cruwaller/FENIX-rx5808-pro-diversity/README.md

https://discord.gg/gG2sjjK

Diversity receiver designed around an ESP32 and touchpad UI.

  *   15 kHz antenna switching rate e.g. once every NTSC video line.
  *   72 selectable frequencies
  *   Rapid spectrum analyser with selectable peaks.  See below for more details.
  *   Switch from diversity mode, to single antenna mode (A or B).

Menu demo (36 seconds) https://www.youtube.com/watch?v=VTEIN2PMyIs

Indoor flight (29 seconds) https://www.youtube.com/watch?v=gvrL2I_6KYo

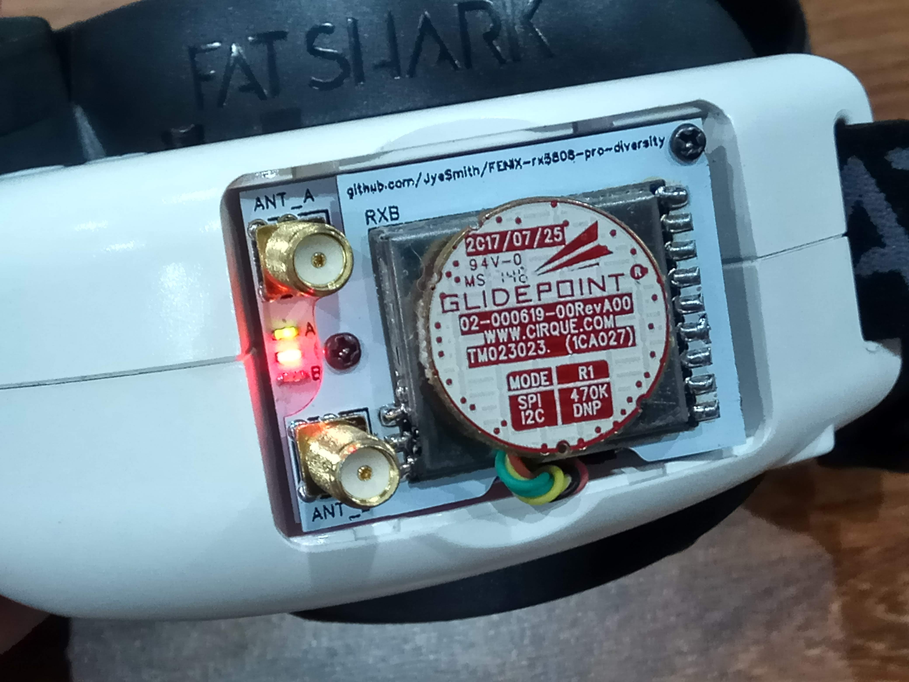
[picture p1: docs/img/InGoggles.jpg]


**Calibration**

When first built and turned on you will be greeted with a calibration screen.  Set a VTx to 25 mW and on your favourite band/frequency (F4 for 5800 MHz) and place the VTx next to the goggles.  Tap the touchpad and the module will sweep all frequencies tracking maximum and minimum RSSI values.  When completed you will see the final min/max values for each receiver and can tapping again saves these values.

The calibration process can be repeated by tapping the ‘on time’ in the upper right corner.  This will change when a proper settings menu has be completed.

**Band selection**

Cycle through bands A, B, E, F, R, L, U, O, H by tapping on the upper or lower half of the band letter.

**Channel selection**

Cycle through channels 1-8 by tapping on the upper or lower half of the channel number.

**Diversity or single antenna selection**

Tapping on mode cycles through diversity, antenna A, and antenna B modes.

**Spectrum analyser**

Moving the cursor to the lower half of the screen starts the spectrum analyser.

_**Note** the screen will timeout after 2 seconds when the cursor is in the top half of the screen, but will not timeout when in the lower half and spectrum analyser is running._

The spectrum displays the RSSI detected for each of the 72 channels/bands.  A peak can be tapped on to select this frequency.  When selecting a peak the module will sweep across the peak in 1 MHz steps and determine the center frequency of the peak.  The receivers are then set to the band/channel closest to this center frequency.

## BOM

  *   1 x PCB - Upload the Gerber.zip found in the PCB folder to jlcpcb.com, select 1mm thickness and your favourite colour. https://easyeda.com/jyesmith/esp32-fatshark-module-v3
  *   1 x GlidePoint circle pads Part Number (SPI) TM023023-2024-002
     *   https://www.cirque.com/glidepoint-circle-trackpads
     *   https://au.mouser.com/ProductDetail/Cirque/TM023023-2024-002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
  *   1 x TTGO Micro-32
     *   https://www.aliexpress.com/item/Ttgo-Micro-32-V2-0-Wifi-Wireless-Bluetooth-Module-Esp32-Pico-D4-Ipex-Esp-32/32982085061.html
  *   2 x RX5808.  The receiver linked below has given better results than the more commonly available receiver (the version without the 2 extra tabs).  The RSSI voltage range is  larger and the minimum RSSI is consistent across all frequencies.
     *   https://www.aliexpress.com/item/Swiftflying-Boscam-FPV-5-8G-Wireless-Audio-Video-Receiving-Module-For-RX5808/32841092602.html
  *   2 x Antenna Connectors
     *   https://www.aliexpress.com/item/5-pcs-RF-Coaxial-Long-SMA-Female-Straight-Edge-15mm-tooth-PCB-Connector-Adapter/32913905715.html
  *   1 x SPDT Analog Switch TS5A3159ADBVR SOT-23
     *   http://www.ti.com/lit/ds/symlink/ts5a3159a.pdf
  *   3.3V Regulator AMS1117-3.3
  *   2 x 10uF 0603 SMD Capacitors
  *   1 x 0.1uF 0603 SMD Capacitor
  *   1 x 10k 0603 SMD Resistors (EN pullup)
  *   2 x 100k 0603 SMD Resistors (RSSI pulldown)
  *   3 x 510 ohm 0603 SMD Resistors (LEDs) (Optional)
  *   3 x 0603 LEDs.  1 (red) for power and 2 (green) for indicating which antenna is selected (Optional)
  *   1 x boot button
  *   1 x 9 pin header
  *   2 x 4mm M2 standoffs and screws

# Wiring

https://easyeda.com/jyesmith/esp32-fatshark-module-v3

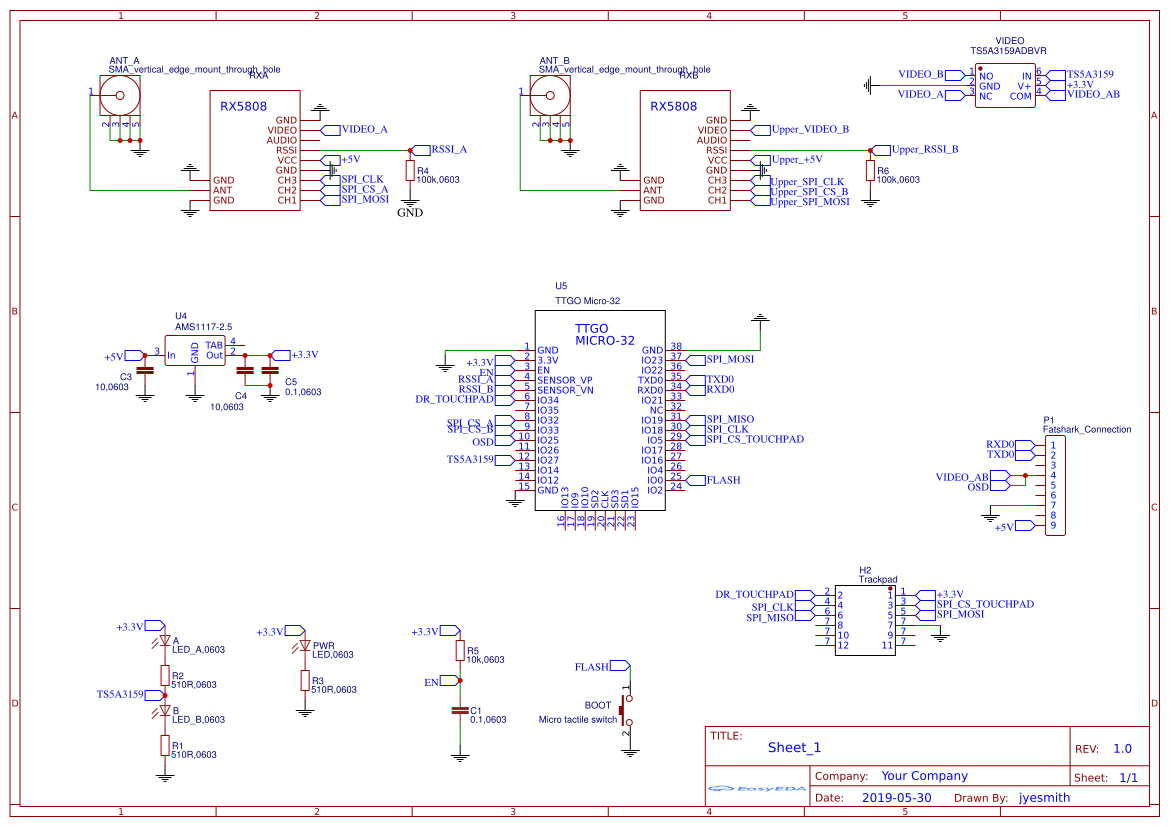
[picture p2: PCB/Schematic.png]
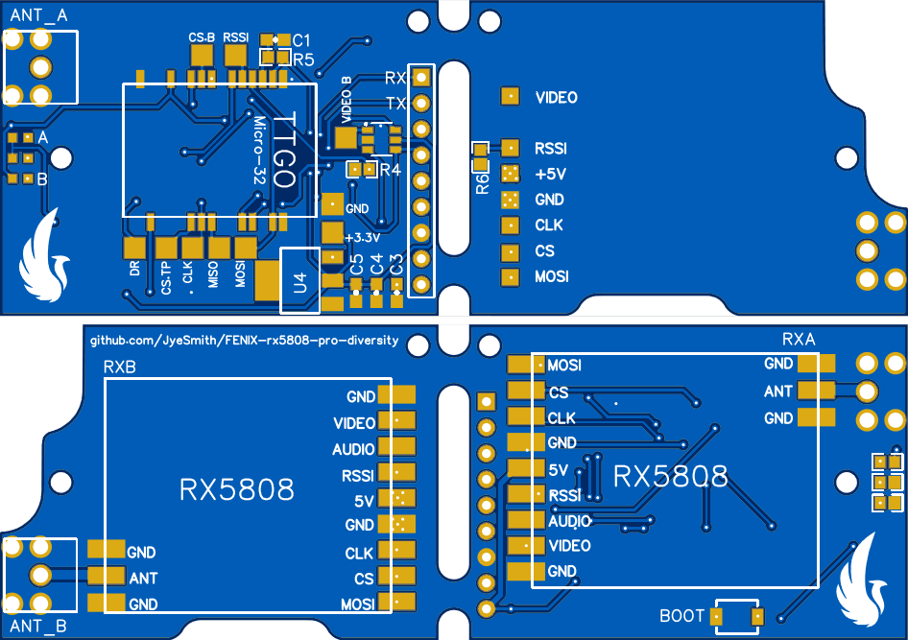
[picture p3: PCB/PCB.png]
 

The touchpad works better with a cover.  I use a piece of electric tape.

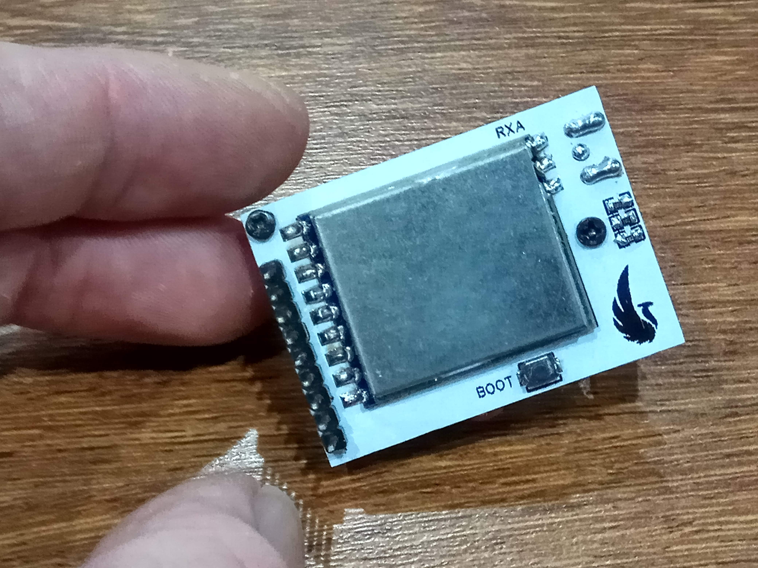
[picture p4: docs/img/BackFinished.jpg]
 

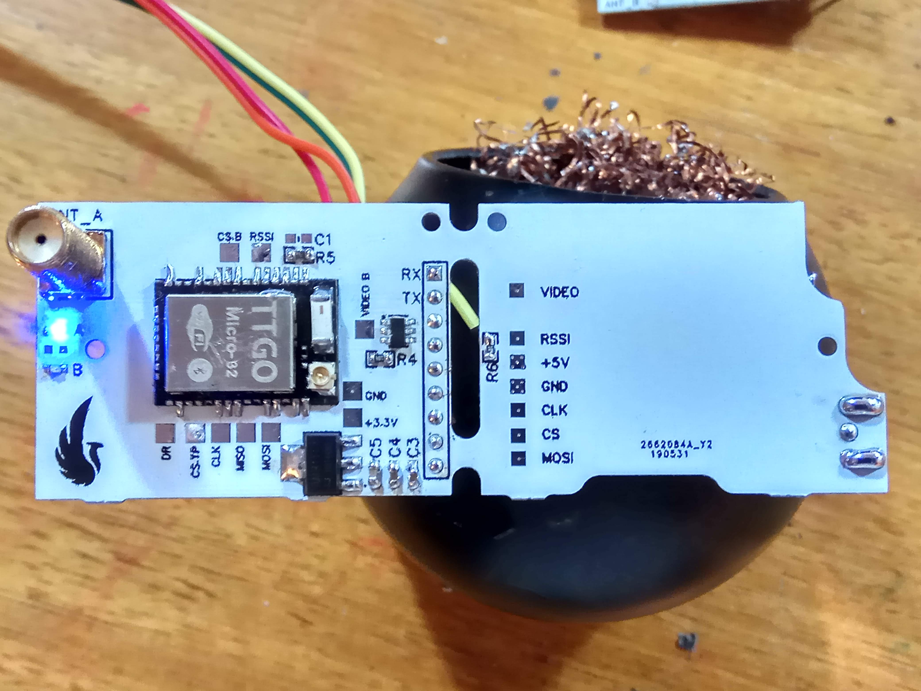
[picture p5: docs/img/Front1Build.jpg]
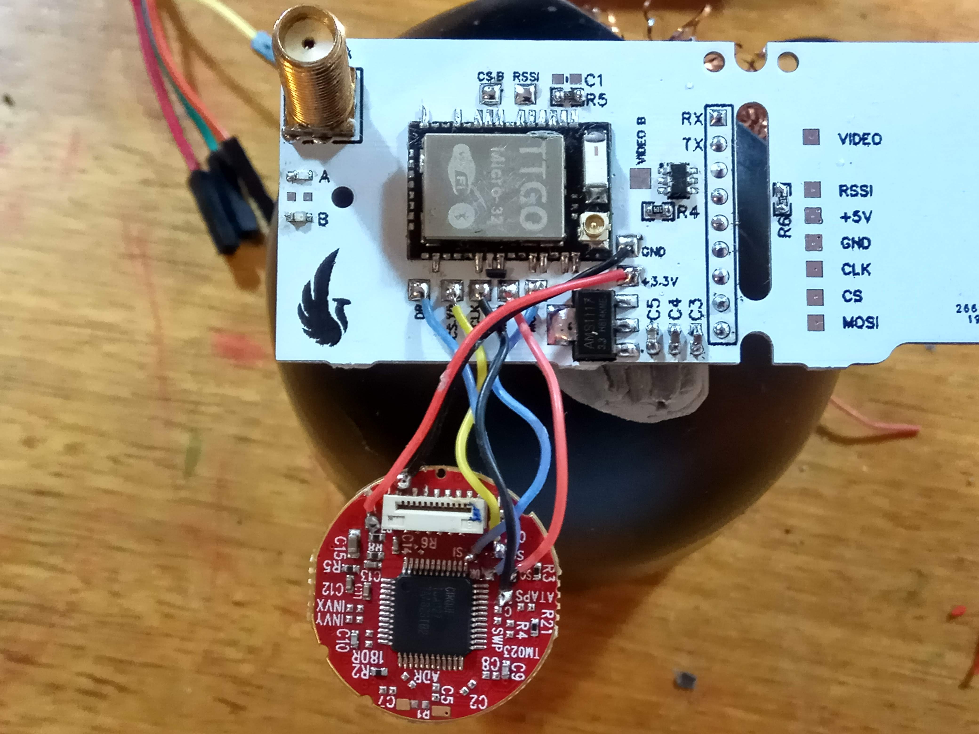
[picture p6: docs/img/Front2Build.jpg]
 

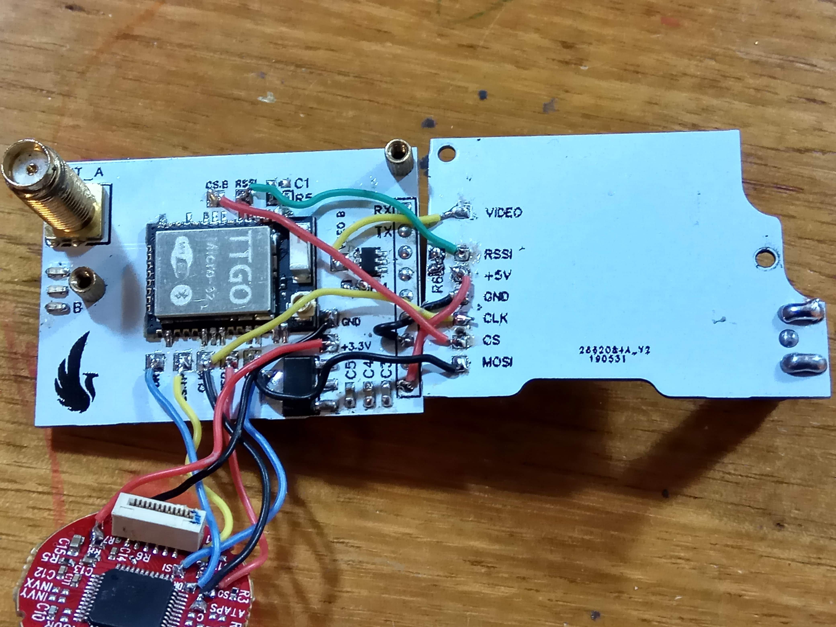
[picture p7: docs/img/Front3Build.jpg]
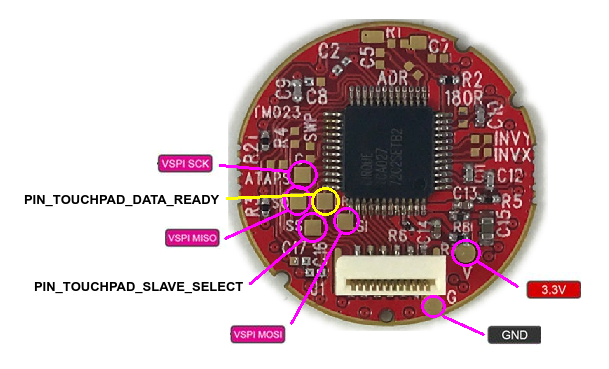
[picture p8: docs/img/TouchPadWiring.png]
 

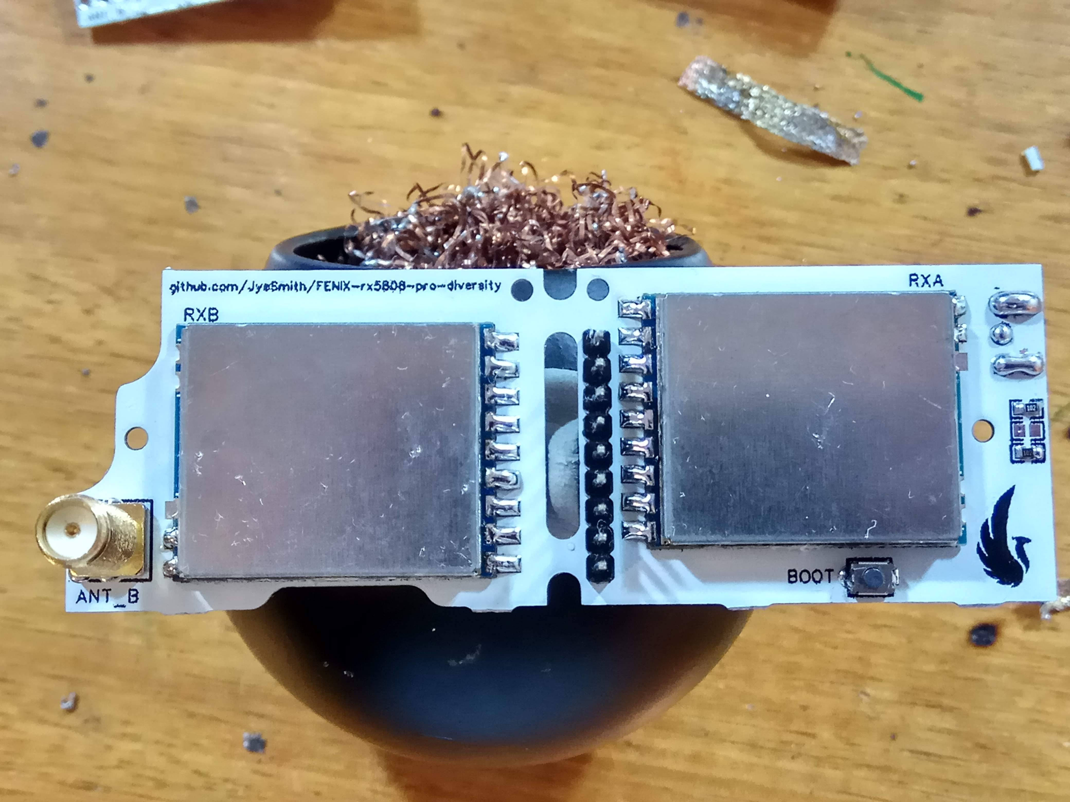
[picture p9: docs/img/BackBuild.jpg]


## Flashing

Tx and Rx pins to the TTGO are broken out to the upper 2 pins that plug into the goggles.  Connect these, along with GND (pin 3rd from bottom) and 5V (bottom pin), then flash using your favourite FTDI.

## Recognition

This code is a forked from [sheaivey/rx5808-pro-diversity](https://github.com/sheaivey/rx5808-pro-diversity).

## Code

The code is distributed under the [MIT license](LICENSE.md).
