cruwaller/FENIX-rx5808-pro-diversity/src/src/rx5808-pro-diversity.cpp

/*
   SPI driver based on fs_skyrf_58g-main.c Written by Simon Chambers
   TVOUT by Myles Metzel
   Scanner by Johan Hermen
   Inital 2 Button version by Peter (pete1990)
   Refactored and GUI reworked by Marko Hoepken
   Universal version my Marko Hoepken
   Diversity Receiver Mode and GUI improvements by Shea Ivey
   OLED Version by Shea Ivey
   Seperating display concerns by Shea Ivey

  The MIT License (MIT)

  Copyright (c) 2015 Marko Hoepken

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
  THE SOFTWARE IS PROVIDED "AS IS", WITHOUT WARRANTY OF ANY KIND, EXPRESS OR
  IMPLIED, INCLUDING BUT NOT LIMITED TO THE WARRANTIES OF MERCHANTABILITY,
  FITNESS FOR A PARTICULAR PURPOSE AND NONINFRINGEMENT. IN NO EVENT SHALL THE
  AUTHORS OR COPYRIGHT HOLDERS BE LIABLE FOR ANY CLAIM, DAMAGES OR OTHER
  LIABILITY, WHETHER IN AN ACTION OF CONTRACT, TORT OR OTHERWISE, ARISING FROM,
  OUT OF OR IN CONNECTION WITH THE SOFTWARE OR THE USE OR OTHER DEALINGS IN THE
  SOFTWARE.
*/


#include "settings.h"
#include "settings_eeprom.h"
#include "state_home.h"
#include "channels.h"
#include "receiver.h"
#include "receiver_spi.h"
#include "state.h"
#include "ui.h"
#include "voltage.h"
#include "temperature.h"
#include "touchpad.h"
#include "receiver_spi.h"
#include "comm_espnow.h"

#include <SPI.h>

void setupPins();

#ifdef SPEED_TEST
uint32_t speed_test_hz = 0;
uint32_t speed_test_previousTime = 0;
#endif

void setup()
{
#if DEBUG_ENABLED || defined(SPEED_TEST)
    Serial.begin(115200);
#endif

    EepromSettings.setup();
    setupPins();

    SPI.begin();
    SPI.setHwCs(false);

    StateMachine::setup();
    Ui::setup();
    TouchPad::setup();

    /* Setup receivers and cofigure its registers */
    ReceiverSpi::setup();

    // Has to be last setup() otherwise channel may not be set.
    // RX possibly not booting quick enough if setup() is called earler.
    // delay() may be needed.
    Receiver::setup();

    if (!EepromSettings.isCalibrated) {
        StateMachine::switchState(StateMachine::State::SETTINGS_RSSI);
        Ui::tvOn();
    } else {
        StateMachine::switchState(StateMachine::State::HOME);
    }

    comm_espnow_init();
}

void setupPins() {

#if !DEBUG_ENABLED && !defined(SPEED_TEST)
    // Rx and Tx set as input so that they are high impedance when conencted to goggles.
    pinMode(1, INPUT);
    pinMode(3, INPUT);
#endif

    // Init CS pins here to make sure those are in correct state before configuration is performed
    pinMode(PIN_TOUCHPAD_SLAVE_SELECT, OUTPUT);
    digitalWrite(PIN_TOUCHPAD_SLAVE_SELECT, HIGH);

    pinMode(PIN_SPI_SLAVE_SELECT_RX_A, OUTPUT);
    digitalWrite(PIN_SPI_SLAVE_SELECT_RX_A, HIGH);

    pinMode(PIN_SPI_SLAVE_SELECT_RX_B, OUTPUT);
    digitalWrite(PIN_SPI_SLAVE_SELECT_RX_B, HIGH);

    pinMode(PIN_RX_SWITCH, OUTPUT);
    digitalWrite(PIN_RX_SWITCH, LOW);

    pinMode(PIN_RSSI_A, INPUT);
    pinMode(PIN_RSSI_B, INPUT);
#ifdef PIN_VBAT
    analogSetPinAttenuation(PIN_VBAT, ADC_2_5db);
#endif
}

void loop() {
    Receiver::update();
    TouchPad::update();

    if (Ui::isTvOn) {

#ifdef USE_VOLTAGE_MONITORING
        Voltage::update();
#endif
        Ui::display.begin(0); // reset OSD to black
        StateMachine::update();
        Ui::update();
        Ui::display.end(); // draw OSD

        if (Ui::UiTimeOut.hasTicked() &&
            StateMachine::currentState != StateMachine::State::SETTINGS_RSSI )
        {
            Ui::tvOff();
            EepromSettings.update();
        }
    }
    else if (TouchPad::touchData.buttonPrimary) // TV is off, check if touch has happened
    {
        Ui::tvOn();
    }

    TouchPad::clearTouchData();

#ifdef SPEED_TEST
        speed_test_hz++;
        uint32_t nowTime = millis();
        if (1000u <= (nowTime - speed_test_previousTime)) {
            Serial.print(speed_test_hz);
            Serial.println(" Hz");
            speed_test_previousTime = nowTime;
            speed_test_hz = 0;
        }
#endif // SPEED_TEST
}
