cruwaller/FENIX-rx5808-pro-diversity/src/src/settings.h

/*
 * Setings file by Shea Ivey

The MIT License (MIT)

Copyright (c) 2015 Shea Ivey

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
THE SOFTWARE IS PROVIDED "AS IS", WITHOUT WARRANTY OF ANY KIND, EXPRESS OR
IMPLIED, INCLUDING BUT NOT LIMITED TO THE WARRANTIES OF MERCHANTABILITY,
FITNESS FOR A PARTICULAR PURPOSE AND NONINFRINGEMENT. IN NO EVENT SHALL THE
AUTHORS OR COPYRIGHT HOLDERS BE LIABLE FOR ANY CLAIM, DAMAGES OR OTHER
LIABILITY, WHETHER IN AN ACTION OF CONTRACT, TORT OR OTHERWISE, ARISING FROM,
OUT OF OR IN CONNECTION WITH THE SOFTWARE OR THE USE OR OTHER DEALINGS IN THE
SOFTWARE.
*/

#ifndef SETTINGS_H
#define SETTINGS_H

#define VERSION_NUMBER 0002


// === Features ===============================================================

// You can use any of the arduino analog pins to measure the voltage of the
// battery. See additional configuration below.

//#define USE_VOLTAGE_MONITORING

//#define USE_TEMPERATURE_MONITORING

//#define USE_PRINT_ON_TIME

// Can enable this to powerdown the audio blocks on the RX58xx if you don't
// need it. Save a tiny bit of power, make your videos less noisy.

// WARNING: Makes RSSI act a little weird.
#define DISABLE_AUDIO

// Wifi update params
#define STASSID "FENIX.PeHo"

/* How many channel receiver has */
// #define CHANNELS_72
#define CHANNELS_48

/* Video output mode: PAL or NTSC */
#define VIDEO_MODE PAL

// === ESP-NOW =================================================================

/* Defines ESPNOW peers and allow to exchange values between nodes
 *  Currently ELRS and Chorus32 are supported!
 */
#define ESP_NOW_ENABLED      1
#define ESP_NOW_PEERS_ELRS   {0x5C, 0xCF, 0x7F, 0xAC, 0xD9, 0x0F}, {0x5E, 0xCF, 0x7F, 0xAC, 0xD9, 0x0F}
#define ESP_NOW_PEERS_CHORUS {0xF0, 0x08, 0xD1, 0xD4, 0xED, 0x7D}

// === Pins ====================================================================

#define PIN_SPI_SLAVE_SELECT_RX_A       32
#define PIN_SPI_SLAVE_SELECT_RX_B       33

#define PIN_RX_SWITCH                   27

#define PIN_RSSI_A                      36
#define PIN_RSSI_B                      39

#define PIN_TOUCHPAD_SLAVE_SELECT       5
#define PIN_TOUCHPAD_DATA_READY         34

//#define PIN_VBAT                        35

// === Voltage Monitoring ======================================================

// Voltage levels
#define WARNING_VOLTAGE 72 // 3.6V per cell for 2S
#define CRITICAL_VOLTAGE 66 // 3.3V per cell for 2S
#define VBAT_SCALE 26 // 100k 10k resistor potential divider
#define VBAT_OFFSET 0

// Alarm sounds
#define ALARM_EVERY_SEC 20000
#define CRITICAL_BEEP_EVERY_MSEC 400
#define CRITICAL_BEEPS 3
#define WARNING_BEEP_EVERY_MSEC 200
#define WARNING_BEEPS 2

// === RSSI ====================================================================

// RSSI default raw range.
#define RSSI_MIN_VAL 500
#define RSSI_MAX_VAL 2000

// Scan loops for setup run.
#define RSSI_SETUP_RUN 1

// === Misc ====================================================================

#define EEPROM_SAVE_TIME 1000

#define BEEPER_CHIRP 25

//#define SPEED_TEST

//#define DEBUG_ENABLED 1

#define POWER_OFF_RX 1

#define HOME_SHOW_LAPTIMES 1

// === Sanity checks and defaults ==============================================

#ifndef PIN_VBAT
#undef USE_VOLTAGE_MONITORING
#endif
#ifndef STASSID
#define STASSID "FENIX"
#endif // STASSID

#endif // file_defined
