cruwaller/FENIX-rx5808-pro-diversity/src/src/state_home.h

#ifndef STATE_HOME_H
#define STATE_HOME_H

#include "channels.h"
#include "state.h"
#include "settings.h"
#include "receiver.h"

namespace StateMachine {
    class HomeStateHandler : public StateMachine::StateHandler {
        private:
            void onUpdateDraw(uint8_t tapAction);

            uint8_t displayActiveChannel = 0;
            bool wasInBandScanRegion = false;
            bool isInBandScanRegion();
            void bandScanUpdate();

            void setChannel(int channelIncrement, int setChannel = -1);
            void centreFrequency();
            bool centred = false;

            uint8_t orderedChanelIndex = 0;
            uint8_t lastChannelIndex = 0;

        public:
            void onEnter();
            void onUpdate();
    };
}

#endif
