cruwaller/FENIX-rx5808-pro-diversity/src/src/touchpad.h

#ifndef TOUCHPAD_H
#define TOUCHPAD_H

#include <stdint.h>
#include <esp_attr.h>
#include <esp8266-compat.h>


#define GESTURES_ENABLED 0

namespace TouchPad {

    typedef struct _relData
    {
      bool buttonPrimary;
      bool buttonSecondary;
      bool buttonAuxiliary;
      int8_t xDelta;
      int8_t yDelta;
      bool xSign;
      bool ySign;
      int16_t cursorX;
      int16_t cursorY;

      int32_t timeLastButtonPress;
      bool buttonOrderChecked;
      bool switchButtonOrder;
    } relData_t;

    extern relData_t DMA_ATTR touchData;

    enum class Gesture : uint8_t {
        Up,
        Down,
        Left,
        Right,
        Nope
    };

    void setup();
    void IRAM_ATTR update();
    void IRAM_ATTR clearTouchData();
}

#endif
