cruwaller/FENIX-rx5808-pro-diversity/src/src/protocol_chorus.h

#ifndef _PROTOCOL_CHORUS_H_
#define _PROTOCOL_CHORUS_H_

#include <stdint.h>

uint8_t chorus_race_is_start(void);
void chorus_race_state_set(uint8_t);

void chorus_race_start(void);
void chorus_race_end(void);
void chorus_race_laps_get(void);

uint8_t chorus_race_lap_time_min(void);
void    chorus_race_lap_time_min_get(void);
void    chorus_race_lap_time_min_change(int val);

void chorus_command_handle(uint8_t const * buff, uint8_t len);
#endif /* _PROTOCOL_CHORUS_H_ */
