cruwaller/FENIX-rx5808-pro-diversity/src/src/protocol_ExpressLRS.cpp

#include "protocol_ExpressLRS.h"
#include "comm_espnow.h"
#include "settings.h"
#include "msp.h"
#include "msptypes.h"

// ELRS specific opcodes
#define ELRS_PARAMS_GET        0x00
#define ELRS_PARAMS_RF_MODE    0x01
#define ELRS_PARAMS_TLM_RATE   0x02
#define ELRS_PARAMS_TX_PWR     0x03
#define ELRS_PARAMS_FREQ       0x04
#define ELRS_PARAMS_START_WIFI 0x05


struct elrs_params {
    uint8_t rate;
    uint8_t tlm;
    uint8_t pwr;
    uint8_t pwr_max;
    uint8_t region;
};

struct elrs_params DRAM_ATTR elrs_params;
mspPacket_t DRAM_ATTR msp_out;

static void expresslrs_msp_params_send(uint8_t type, uint8_t value)
{
    msp_out.type = MSP_PACKET_V1_ELRS;
    msp_out.flags = MSP_ELRS_INT;
    msp_out.function = ELRS_INT_MSP_PARAMS;
    msp_out.payloadSize = 2;
    msp_out.payload[0] = type;
    msp_out.payload[1] = value;
    comm_espnow_send_msp(&msp_out, ESPNOW_ELRS);
}

void expresslrs_vtx_freq_send(uint16_t freq)
{
    // channel format is 8 * BAND + CHANNEL

    msp_out.type = MSP_PACKET_V2_COMMAND;
    msp_out.flags = MSP_VERSION | MSP_STARTFLAG; // TODO: validate!
    msp_out.function = MSP_SET_VTX_CONFIG;
    msp_out.payloadSize = 2; // 4 => 2, power and pitmode can be ignored
    msp_out.payload[0] = (freq & 0xff);
    msp_out.payload[1] = (freq >> 8);
    //msp_out.payload[2] = 1; // power (25mW)
    //msp_out.payload[3] = 0; // pitmode == (power == 0)
    comm_espnow_send_msp(&msp_out);
}

void expresslrs_rate_send(uint8_t rate)
{
    expresslrs_msp_params_send(ELRS_PARAMS_RF_MODE, rate);
}

void expresslrs_power_send(uint8_t power)
{
    expresslrs_msp_params_send(ELRS_PARAMS_TX_PWR, power);
}

void expresslrs_tlm_send(uint8_t tlm)
{
    expresslrs_msp_params_send(ELRS_PARAMS_TLM_RATE, tlm);
}

void expresslrs_params_get(void)
{
    expresslrs_msp_params_send(ELRS_PARAMS_GET, 0);
}

void expresslrs_params_update(uint8_t rate, uint8_t tlm, uint8_t pwr, uint8_t pwr_max, uint8_t region)
{
    elrs_params.rate = rate;
    elrs_params.tlm = tlm;
    elrs_params.pwr = pwr;
    elrs_params.pwr_max = pwr_max;
    elrs_params.region = region;
}

uint8_t expresslrs_params_get_rate(void)
{
    return elrs_params.rate;
}

uint8_t expresslrs_params_get_tlm(void)
{
    return elrs_params.tlm;
}


uint8_t expresslrs_params_get_power(void)
{
    return elrs_params.pwr;
}


uint8_t expresslrs_params_get_region(void)
{
    return elrs_params.region;
}
