cruwaller/FENIX-rx5808-pro-diversity/src/src/cursor.h

namespace Cursor 
{
const unsigned int xres = 12;
const unsigned int yres = 19;
const unsigned char pixels[] = {
255, 0, 0, 0, 0, 0, 0, 0, 0, 0, 0, 0, 255, 255, 0, 0, 
0, 0, 0, 0, 0, 0, 0, 0, 255, 1, 255, 0, 0, 0, 0, 0, 
0, 0, 0, 0, 255, 1, 1, 255, 0, 0, 0, 0, 0, 0, 0, 0, 
255, 1, 1, 1, 255, 0, 0, 0, 0, 0, 0, 0, 255, 1, 1, 1, 
1, 255, 0, 0, 0, 0, 0, 0, 255, 1, 1, 1, 1, 1, 255, 0, 
0, 0, 0, 0, 255, 1, 1, 1, 1, 1, 1, 255, 0, 0, 0, 0, 
255, 1, 1, 1, 1, 1, 1, 1, 255, 0, 0, 0, 255, 1, 1, 1, 
1, 1, 1, 1, 1, 255, 0, 0, 255, 1, 1, 1, 1, 1, 1, 1, 
1, 1, 255, 0, 255, 1, 1, 1, 1, 1, 1, 1, 1, 1, 1, 255, 
255, 1, 1, 1, 1, 1, 1, 255, 255, 255, 255, 255, 255, 1, 1, 1, 
255, 1, 1, 255, 0, 0, 0, 0, 255, 1, 1, 255, 0, 255, 1, 1, 
255, 0, 0, 0, 255, 1, 255, 0, 0, 255, 1, 1, 255, 0, 0, 0, 
255, 255, 0, 0, 0, 0, 255, 1, 1, 255, 0, 0, 0, 0, 0, 0, 
0, 0, 255, 1, 1, 255, 0, 0, 0, 0, 0, 0, 0, 0, 0, 255, 
255, 0, 0, 0, };
};
