cruwaller/FENIX-rx5808-pro-diversity/src/src/voltage.h

#ifndef VOLTAGE_H
#define VOLTAGE_H


#include "settings.h"
#include "timer.h"


namespace Voltage {
    
    extern uint8_t voltage;
    extern uint8_t voltageDec;
    extern uint16_t prevVoltageRaw;
    
    void update();
}


#endif
