cruwaller/FENIX-rx5808-pro-diversity/src/src/ui.cpp

#include "settings.h"
#include "settings_eeprom.h"
#include "ui.h"
#include "receiver_spi.h"
#include "receiver.h"
#include "touchpad.h"
#include "font8x8.h"
#include "cursor.h"

#include <soc/rtc.h>
#include <stdint.h>

namespace Ui {

    bool DMA_ATTR isTvOn = false;

    Timer DMA_ATTR UiTimeOut = Timer(2000);

    CompositeGraphics DMA_ATTR display(XRES, YRES);
    CompositeOutput DMA_ATTR composite(CompositeOutput::VIDEO_MODE, XRES * 2, YRES * 2);
    Font<CompositeGraphics> DMA_ATTR font(8, 8, font8x8::pixels);

    void setup() {

        // highest clockspeed needed
        rtc_clk_cpu_freq_set(RTC_CPU_FREQ_240M);
        //rtc_clk_cpu_freq_config_set();

        //initializing DMA buffers and I2S
        composite.init();
        //initializing graphics double buffer
        display.init();
        composite.stopOutput(); //stop i2s driver (no video output)
        //select font
        display.setFont(font);

        //running composite output pinned to first core
        xTaskCreatePinnedToCore(compositeCore, "c", 1024, NULL, 255, NULL, 0); //increase priority to remove osd jitter with esp-now
        //rendering the actual graphics in the main loop is done on the second core by default

    }

    void update() {

        drawCursor();

    }

    void compositeCore(void *data)
    {
      while (true)
      {
        //just send the graphics frontbuffer whithout any interruption
        composite.sendFrameHalfResolution(&display.frame);
      }
    }

    void tvOn() {

        ReceiverSpi::rxVideoOff(Receiver::ReceiverId::ALL);

        composite.startOutput();

        isTvOn = true;
    }

    void tvOff() {

        ReceiverSpi::rxPowerUp(Receiver::ReceiverId::ALL);

        Receiver::setChannel(Receiver::activeChannel);

        composite.stopOutput();

        isTvOn = false;
    }

    void drawCursor() {

        uint8_t i = 0, py, px, pixelValue;
        int16_t cursor_x = TouchPad::touchData.cursorX, cursor_y = TouchPad::touchData.cursorY;

        for (py = 0; py < Cursor::yres; py++) {
            for (px = 0; px < Cursor::xres; px++) {
                pixelValue = Cursor::pixels[i++];
                if (pixelValue == 255) {
                    display.dot(px + cursor_x, py + cursor_y, 100);
                } else if (pixelValue == 1) {
                    display.dot(px + cursor_x, py + cursor_y, 0);
                }
            }
        }

    //    // For testing print the cursor location.  Helps with positioning widgits.
    //    display.setCursor(cursor_x, cursor_y);
    //    display.print("  [");
    //    display.print(cursor_x);
    //    display.print(", ");
    //    display.print(cursor_y);
    //    display.print("]");

    }

//    void beep() {
//        uint16_t freq = 5000; // frequency in Hz
//        display.tone(freq, BEEPER_CHIRP);
//    }
//    void beep(uint16_t freq) {
//        display.tone(freq, BEEPER_CHIRP);
//    }

//    void drawBullseye(const int x, const int y,const int r, const int color) {
//      drawCircle(x, y, r-2, color, BLACK);
//      drawFastHLine(x, y, 0, color);
//      drawFastHLine(x-r, y, 2*r+1, color);
//      drawFastVLine(x, y-r, 2*r+1, color);
//    }

}
