cruwaller/FENIX-rx5808-pro-diversity/(commit log)

2018-08-31 adds quadversity based on stm32f103
    Major changes in the commit include moving hardware to stm32f1, the addition of quadversity, and a frequency centering function. Minor changes include adding a choice of home pages, favourites, improved search, spectator mode, model finder, spectrum scanner, choice of screensaver logo, settings page, access to internal variables for fine tunning functions, and a pixel drawing page.
    [logoBetaflight.txt]
2018-08-31 fix(eeprom): excludes custom logo from realacc eeprom
    [settings_eeprom.h, state_settings.cpp]
2018-08-31 fix(receiver): pins corrected with leds for pcb labeling
    [settings.h]
2018-09-04 feat(favourites): adds left and right button band select to favourites
2018-09-07 refact(screensaver): adds RotorRiot screensaver
    Reproduced with permission. Case number is 72775, 6th Sep 2018
2018-09-08 fix(reset): factory reset variable to uint
    [state_settings_internal.cpp]
2018-09-08 fix(speed): made it go faster
    Changed the display resolution so that 72 MHz can be used. Also changed wire to 400kHz.
    [ui.cpp]
2018-09-10 fix(speed): overclocking added at 120 MHz
    120 MHz can now be compiled. See the wiki for further details on how to compile with CPU speed of 120 MHz.
    [settings.h, ui.cpp]
2018-09-10 update(calibration): increased samples
2018-09-10 fix(home): was momentarily displaying A1 on boot
    [receiver.cpp, rx5808-pro-diversity.ino]
2018-09-10 refact(buttons): button timing
2018-09-10 feat(temperature): adds module temperature monitoring
    Temperture is now displayed on the Home Stats age.
2018-09-10 feat(temperature): clean up
2018-09-11 fix(eeprom): diversityHysteresisTimer and rssiStableTimer now working with values from eeprom
    [receiver.cpp, settings.h, state_settings_internal.cpp]
2018-09-12 fix(temperature): made better
2018-09-13 feat(tvout): option to invert colours
    [settings.h, settings_eeprom.h, state_settings.cpp, ui.cpp]
2018-11-02 fix(version): correct numberand increment eeprom
    [settings.h, state_settings.cpp]
2018-11-06 fix(ttvout):
    https://github.com/Tamakichi/ArduinoSTM32_TVout/commit/d3aaf1f92d28721372aaf479b3064c6e9dd10dc9
2018-11-10 fix(bandscan): ui will not timeout while on bandscan
    Also made the cursor have a black inner component.
    [channels.cpp, rx5808-pro-diversity.ino, state_home.cpp, ui.cpp, ui.h]
2018-11-12 fix(touch): corrected band and channel touch regions
    [state_home.cpp]
2018-11-12 fix(calibration): adds calibration to boot
    [rx5808-pro-diversity.ino, state.cpp, state_settings_rssi.cpp, state_settings_rssi.h]
2018-11-12 fix(): works for REALACC_RX5808_PRO_PLUS_OSD
    [settings.h, state_home.cpp]
2018-11-15 fix(receiver) adds SPI
2018-11-15 fix(receiver) fixes reboot loop
    [receiver.cpp, receiver.h, receiver_spi.cpp, receiver_spi.h, rx5808-pro-diversity.ino]
2018-11-15 fix(touchpad) adds SPI
2018-11-15 fix(eeprom) fixes eeprom, needs testing
    [receiver.cpp, rx5808-pro-diversity.ino, settings_eeprom.cpp, settings_eeprom.h]
2018-11-15 add(tvout) needs fix, stack overflow
    [rx5808-pro-diversity.ino, ui.cpp, ui.h]
2018-11-17 fix(tvout) working with composite.stopOutput and .startOutput functionality
    [CompositeOutput.h, rx5808-pro-diversity.ino]
2018-11-18 fix(tvout) functionality complete
    UI still needs finishing and massive code clean!
    [CompositeGraphics.h, channels.cpp, channels.h, receiver.cpp, receiver.h, rx5808-pro-diversity.ino, settings.h, settings_eeprom.cpp]
2018-11-19 fix(home) fixes ui and calibration
    [CompositeGraphics.h, rx5808-pro-diversity.ino, state_home.cpp, state_settings_rssi.cpp, ui.cpp]
2018-11-21 feat(receiver) increase switching resolution
2018-11-21 fix(cursor) used an image and made beautiful
    [settings.h, touchpad.cpp, ui.cpp, ui.h]
2018-11-21 feat(receiver) adds receiver selecting
    Adds the ability to turn off diverity and select a RX to use 100% of the time.
    The DiversityMode enum needs to be moved to receiver.h, but for what ever reason its not working there. RX should also be placed into standby mode to save battery power.
    [receiver.cpp, receiver.h, settings.h, settings_eeprom.h, state.h, state_home.cpp]
2018-11-21 optimise samples and rx settle time
    Loop time is now ~15kHz.
2018-11-21 feat(receiver) adds standby and poweron
    Standby is not wokring as expected. Further testing of the registers required.
2018-11-22 fix(cursor) forgot to add cursor.h :|
    [cursor.h]
2018-11-22 fix(receiver) move DiversityMode to Receiver namespace
    [channels.cpp, receiver.cpp, receiver.h, settings_eeprom.h, state.h, state_home.cpp]
2018-12-06 readme - adds dev schematic
2019-03-16 refact(pins) changes pins to free i2c for potential future use
2019-03-16 fix(rx) receiver switch not being sent in single rx mode
    [receiver.cpp]
2019-06-09 Improves calibrtaion with filter. Calibration reset via UI. Changes to band channel selection.
    Lots of minors changes while flashing on new hardware.
    [receiver.cpp, rx5808-pro-diversity.ino, settings.h, state.cpp, state_home.cpp, state_home.h, state_settings_rssi.cpp, touchpad.cpp]
2019-06-12 fix (UI) screen flashing
    UI flash was caused by eeprom write. Will only write when UI is not on.
    [settings_eeprom.cpp, touchpad.cpp]
2019-06-15 readme - adds all the info!
    [logoBetaflight.txt]
2019-06-15 fix(eeprom) save on ui exit
    [rx5808-pro-diversity.ino]
2019-06-15 fix(gestures) eeprom save
    Stops cursor moving with gestures and saves new channel to eeprom.
    [touchpad.cpp]
2020-02-22 now uses PlatformIO
    Changed to PFIO for development env and also fixes difference between touchpad primary/secondary button order.
    [CompositeGraphics.h, CompositeOutput.h, channels.cpp, channels.h, cursor.h, receiver.cpp, receiver.h]
2020-02-24 sends but interfers with osd causing jitter
    [rx5808-pro-diversity.ino, state_home.cpp, state_home.h]
2020-02-24 fix tool tip on upper end of bandscan
    [state_home.cpp]
2020-02-26 ExpressLRS comms working
    Send packets via esp-now to "Injector" esp32/esp8266 attached to an ExLRS uart.
2020-04-19 fixes double tap when changing menu
    [rx5808-pro-diversity.ino, state_expresslrs.cpp, state_home.cpp, state_menu.cpp, state_settings_rssi.cpp]
2020-05-18 refract, fix deprecated warnings, platform control
    [CompositeOutput.h, rx5808-pro-diversity.ino]
2020-08-13 Menu fixes + tuning
    [CompositeGraphics.h, ExpressLRS_Protocol.cpp, lap_times.cpp, lap_times.h, protocol_chorus.cpp, protocol_chorus.h, receiver_spi.cpp, receiver_spi.h]
2020-08-13 ELRS opcodes fixed + cleanup
    [ExpressLRS_Protocol.cpp, settings.h]
2020-08-16 Chorus party mode fix + laptimer stuff fixes
    [lap_times.cpp, protocol_chorus.cpp, protocol_chorus.h, state_chorus.cpp, state_expresslrs.cpp, state_home.cpp]
2020-08-21 Fixed issue while changing the receiver and ESP attr updates
    [channels.cpp, receiver.cpp, receiver.h, settings_eeprom.cpp, settings_eeprom.h, touchpad.cpp, touchpad.h]
2020-08-24 Chorus: more to control lap timer
2020-08-25 Fix RSSI spektrum handling
    [state_home.cpp]
2020-08-31 general: switch to if
